rishimukherjee31/LCCMR/images/Circuit-Diagram.png

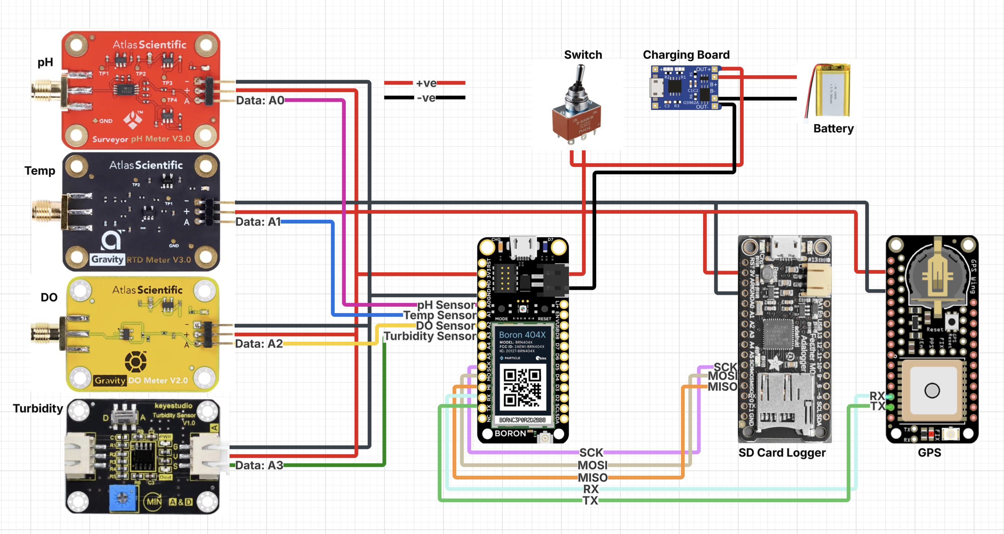
images/Circuit-Diagram.png
