rishimukherjee31/LCCMR/images/Final-Frame-Drawing.png

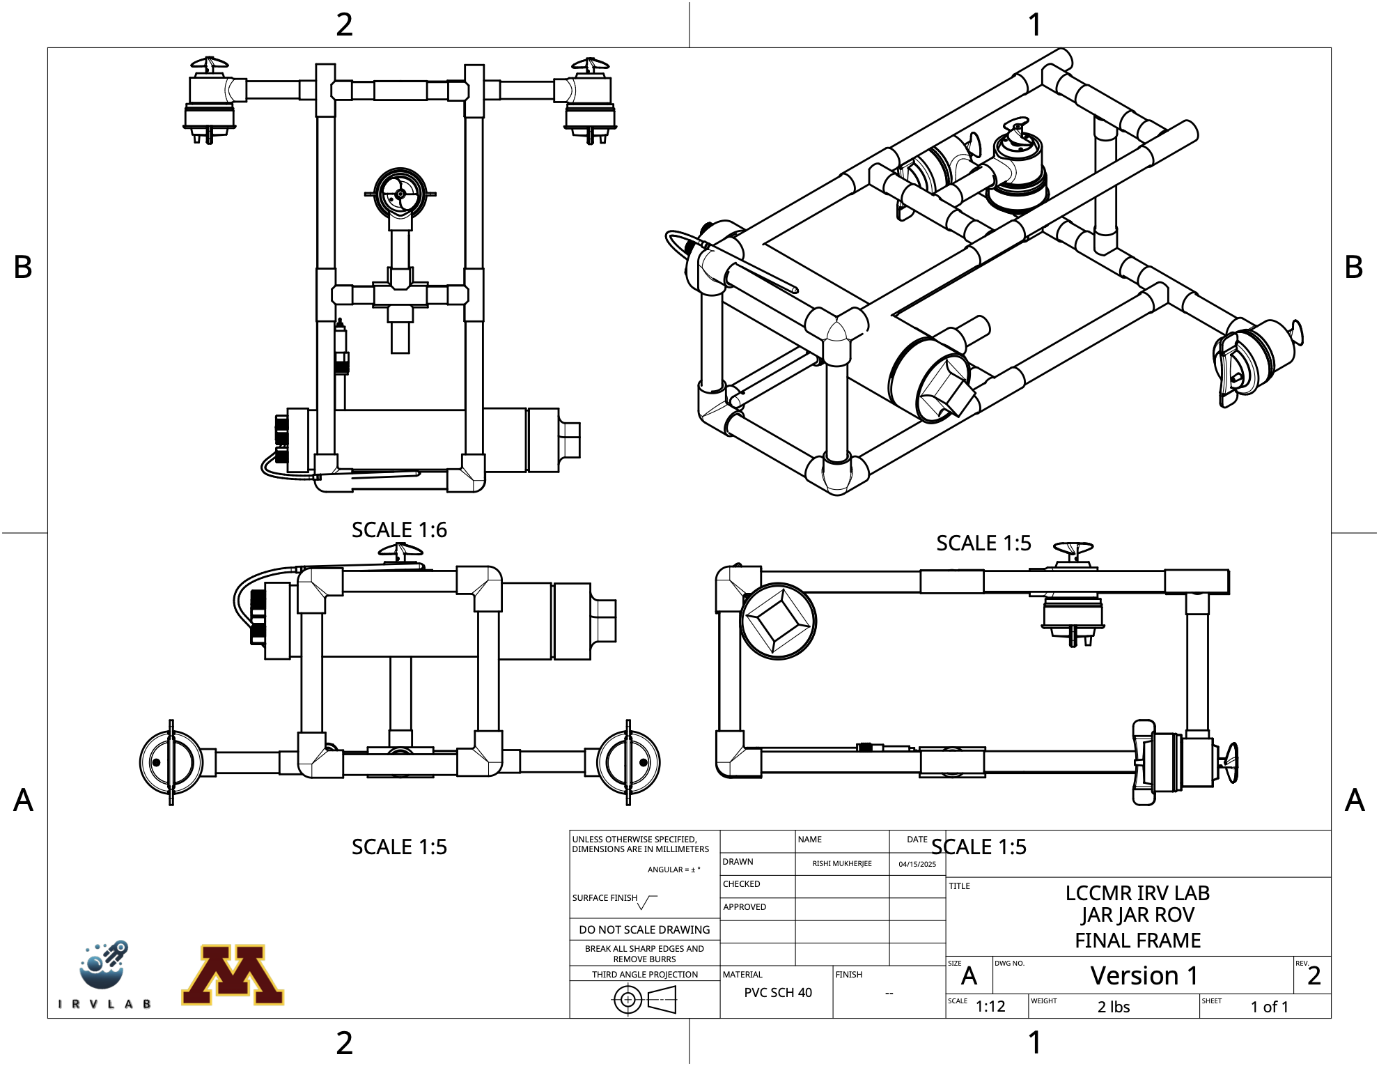
images/Final-Frame-Drawing.png
