rishimukherjee31/LCCMR/sensor-pod-build-guide.md

# Sensor Pod Fabrication and Assembly Guide

The sensor pod housing is made of PVC material SCH40. The main tube is a 2" PVC tube that is cut. It contains the electronics. It is reccomended to build the internal electronics before building the housing.  

<div align="center">
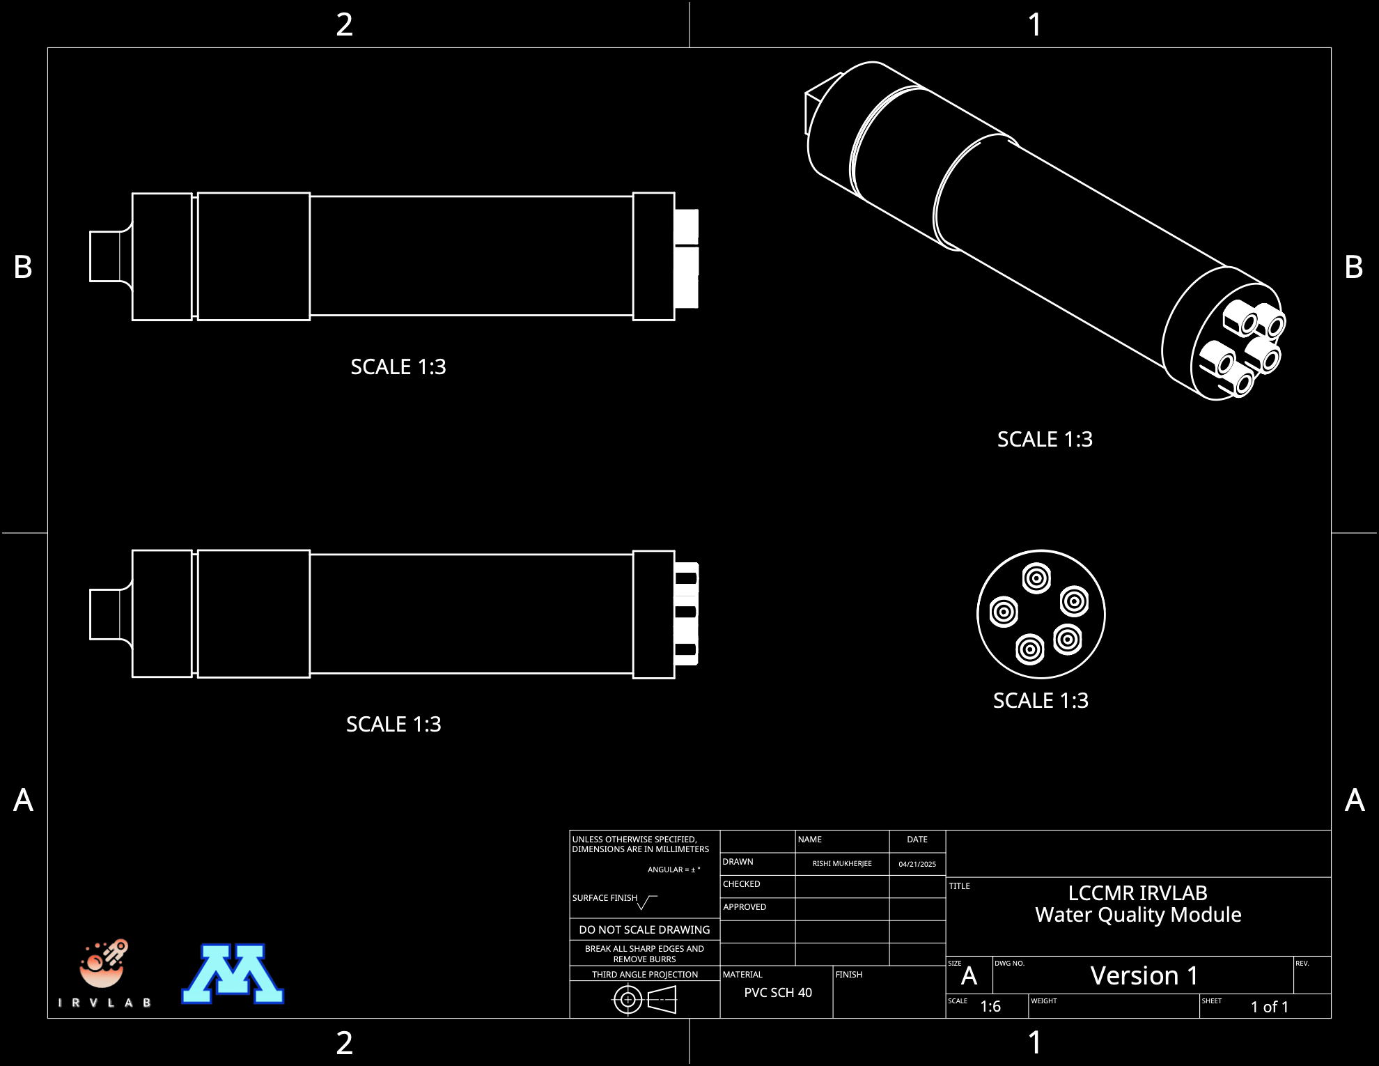
[picture p38: images/image-4.png]
Water Quality Module Housing
  
  <p><em>Water Quality Module Housing</em></p>
</div>
<br>

## Quick Links

- [Parts List](#parts-list)
- [Fabrication Guide](#fabrication-guide)
- [Assembly Guide](#assembly-guide)
- [Ballasting](#ballasting)

<br>

## Parts List

### 1. Required Tools:

<table align="center">
  <tr>
    <th>Hand Saw</th>
    <th>PVC Cement</th>
    <th>Rubber Mallet</th>
    <th>Dremel Tool</th>
  </tr>
  <tr>
    <td>saw</td>
    <td>pvc cement</td>
    <td>rubber mallet</td>
    <td>dremel</td>
  </tr>
</table>

> The fabrication process is not too involved for this module. Most of the parts are available individually off the shelf. The fabrication involves cutting the main 2" pipe to size.
> The assembly includes using PVC cement to glue the caps in place. 

<br>

### 2. Raw Materials:

<table align="left-center">
  <tr>
    <th>Item</th>
    <th>Quantity</th>
    <th>Picture</th>
  </tr>
  <tr>
    <td><a href="https://www.homedepot.com/p/NDS-PVC-S-D-Cap-4-in-4P06/100172701">2" PVC End Cap</a></td>
    <td align="center">1</td>
    <td>1/2" PVC Tee</td>
  </tr>
  <tr>
    <td><a href="https://www.homedepot.com/p/NIBCO-4-in-PVC-DWV-Street-Spigot-x-FIPT-Female-Adapter-C48032HD4/100677982">2" PVC Adapter</a></td>
    <td align="center">1</td>
    <td>1/2"x10' PVC pipe</td>
  </tr>
  <tr>
    <td><a href="https://www.homedepot.com/p/Charlotte-Pipe-2-in-x-2-ft-PVC-DWV-Schedule-40-Pipe-PVC072000200HA/100585960">2" PVC Pipe, 2 ft.</a></td>
    <td align="center">1</td>
    <td>2" PVC Pipe</td>
  </tr>
  <tr>
    <td><a href="https://www.homedepot.com/p/Charlotte-Pipe-2-in-PVC-Schedule-40-S-x-S-Coupling-PVC021001600HD/203811391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">2” PVC Coupler</a></td>
    <td align="center">4</td>
    <td>1/2" PVC 4-way</td>
  </tr>
  <tr>
    <td><a href="https://www.homedepot.com/p/Charlotte-Pipe-2-in-PVC-DWV-Cleanout-Plug-PVC001060800HD/203391575">2" PVC Plug</a></td>
    <td align="center">1</td>
    <td>Pool Noodle</td>
  </tr>
</table>

<br>

## Fabrication Guide

The disassemmbled water quality module housing can be seen in the image below. As you can tell, the PVC pipe needs to be cut to size. All of the other parts are available off the shelf and need to be assembled with PVC cement. The end cap needs to be drilled to accommodate the connectors. It is recommended to build the epoxied connections prior to building this module. 

<br>

<div align="center">
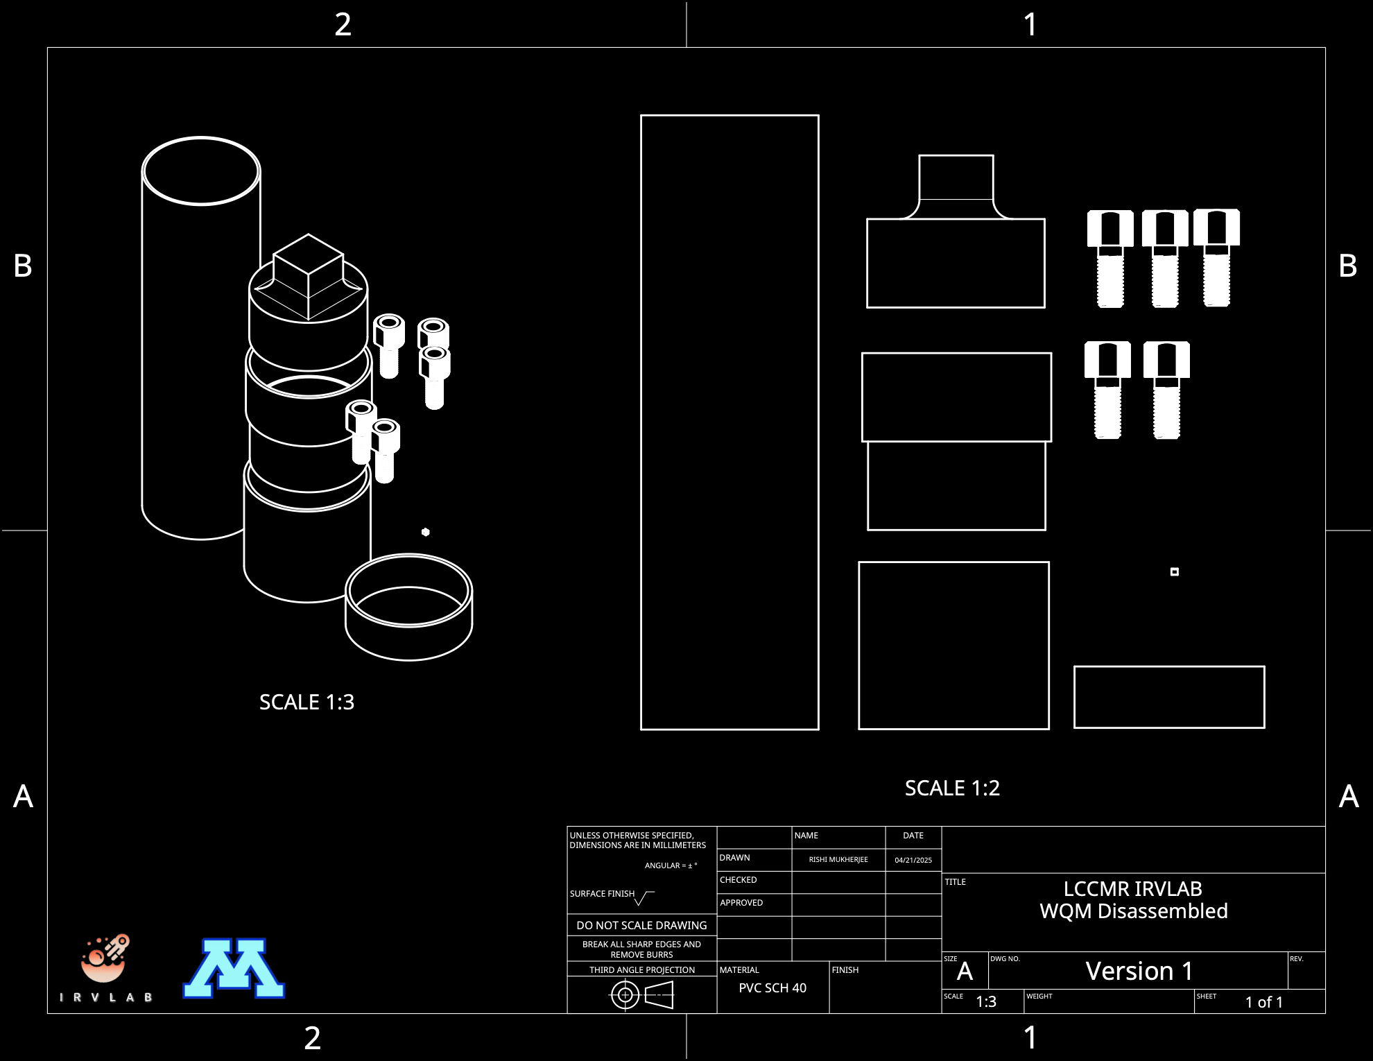
[picture p39: images/image-5.png]
Water Quality Module Disaasembled
  
  <p><em>Water Quality Module Disassembled</em></p>
</div>

<br>

#### Fabricated Parts List

| Quantity | Component | Size | Function |
|:---:|---|---|---|
| 1 | Long housing pipe | 230 mm | Main housing chasis |
| 1 | PVC End Cap | 2" | End Cap |
| 1 | PVC Coupler | 2" | Coupler |
| 1 | PVC Plug | 2" | Plug |
| 1 | PVC Adapter | 2" | Adapter |

<br>

## Assembly Guide

You need to build the thruster joint for the Sea Mate ROV. It is reccomended to build the entire ROV electronics before starting the final assembly. Once all the parts are fabricated, you can start assembling the frame as shown below. Use the images as a guide to assembling the ROV frame. All of the parts are highlighted in their respective final positions. 

<br>

### Penetrators
*The penetrators need to be attached to the back of the first end cap. Do this before assembling the sensor pod.*

Very short horizontal pipes

### Long Housing Pipe 
*Main housing chassis.*

Long horizontal pipes

### Assembly Step 1
*With pvc cement, attach the end cap to one side and the coupler to the other side of the tube*

Tee connectors

> Note: Once you attach a pipe to a connector, make sure to hammer it in place with a rubber mallet. 

### Assembly Step 2
*Attach the adapter using pvc cement.*

Medium vertical pipes

### Assembly Step 3 
*Screw in plug with electrical tape around the threads.*

Short horizontal pipes

### Assemble Step 4
*Attach the Sensor Pod to the top of the frame away from the thrusters.*

Short horizontal pipes
