rishimukherjee31/LCCMR/images/Frame Disassembled Drawing.png

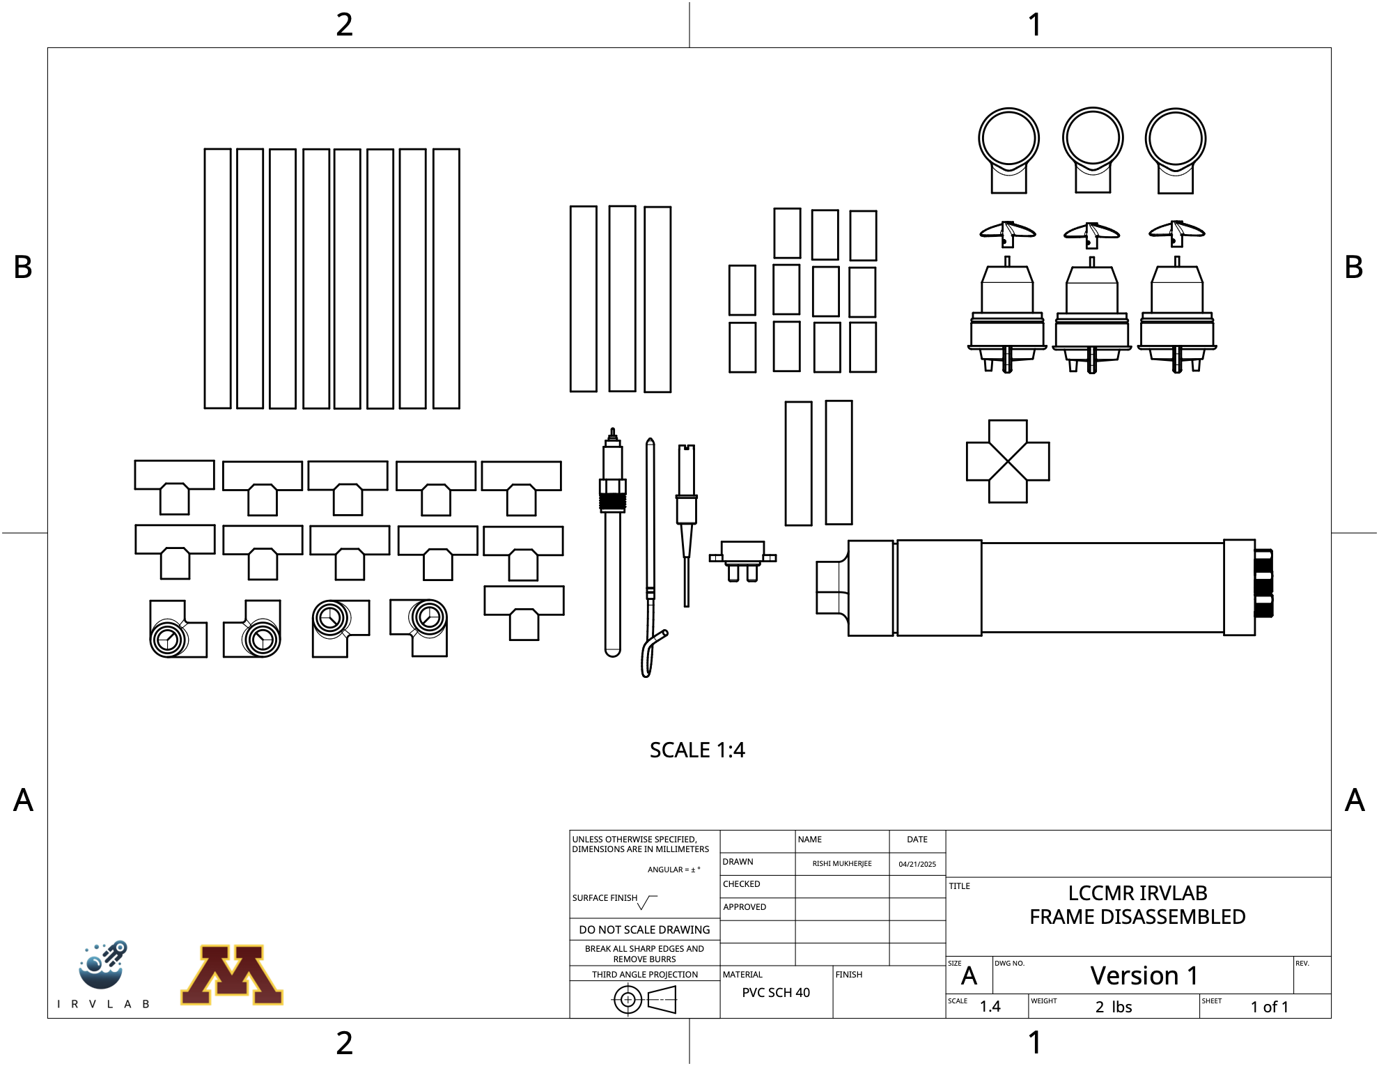
images/Frame Disassembled Drawing.png
